fryktoria/arduino_Gaming_Controller/schematics/Sheet_2.png

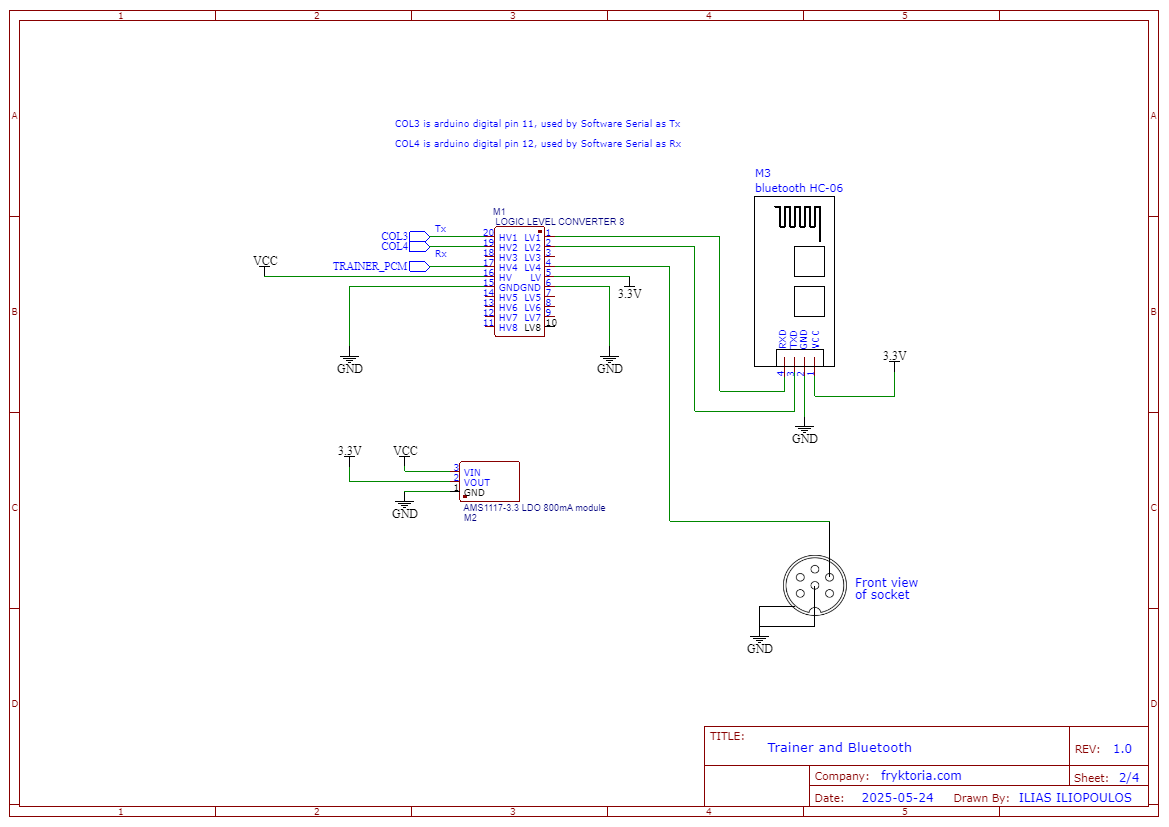
schematics/Sheet_2.png
