fryktoria/arduino_Gaming_Controller/schematics/Sheet_3.png

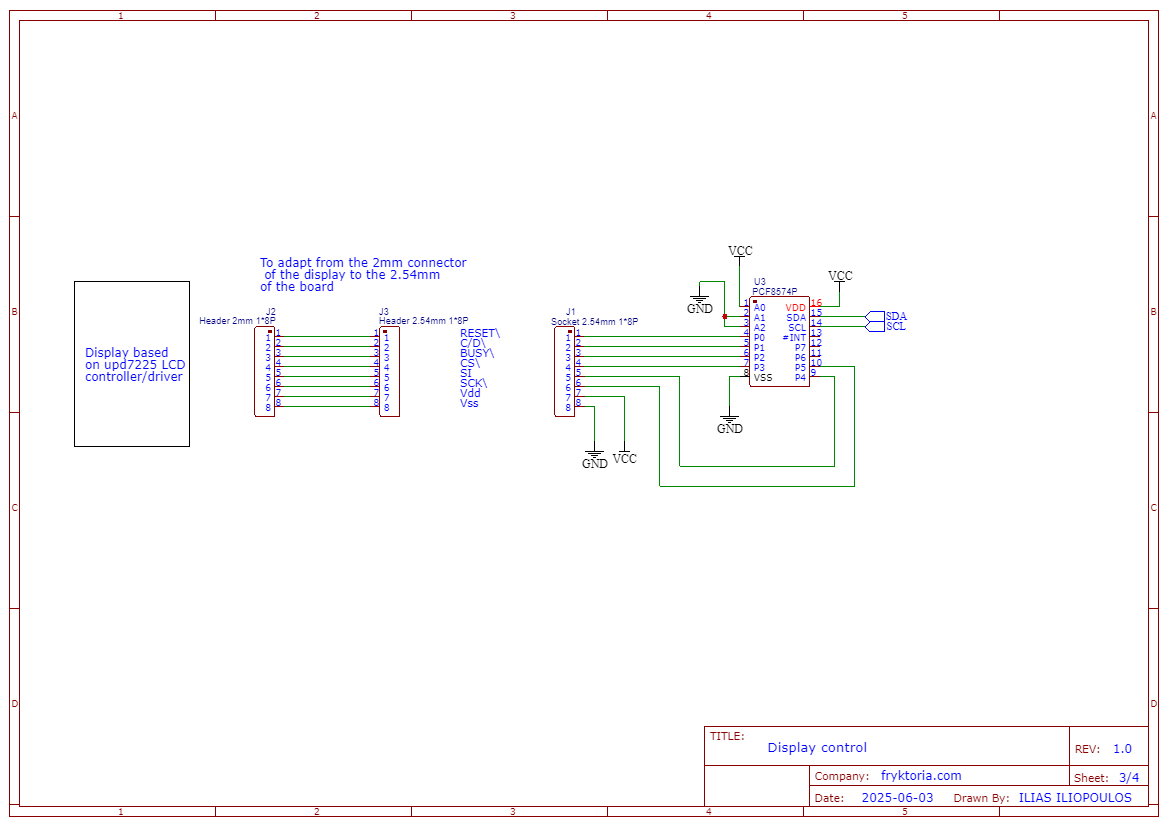
schematics/Sheet_3.png
