fryktoria/arduino_Gaming_Controller/schematics/Sheet_4.png

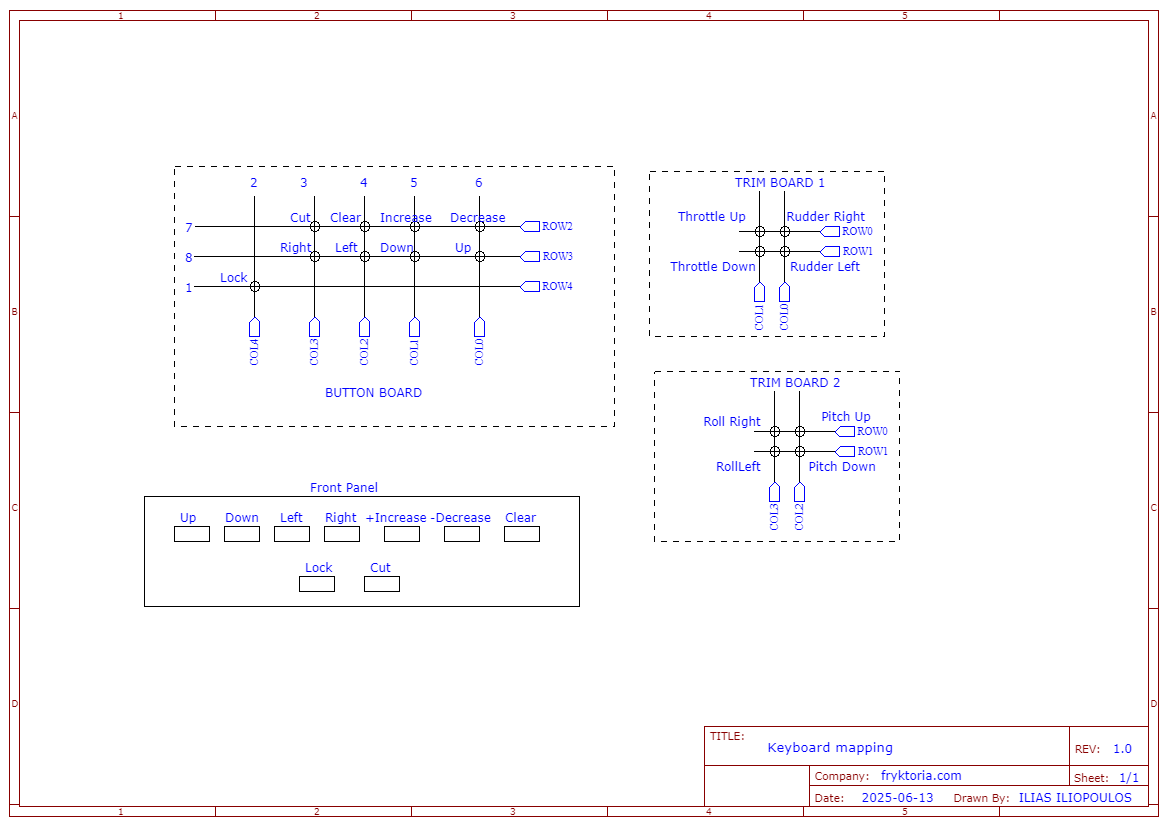
schematics/Sheet_4.png
