fryktoria/arduino_Gaming_Controller/schematics/schematics_pages.pdf

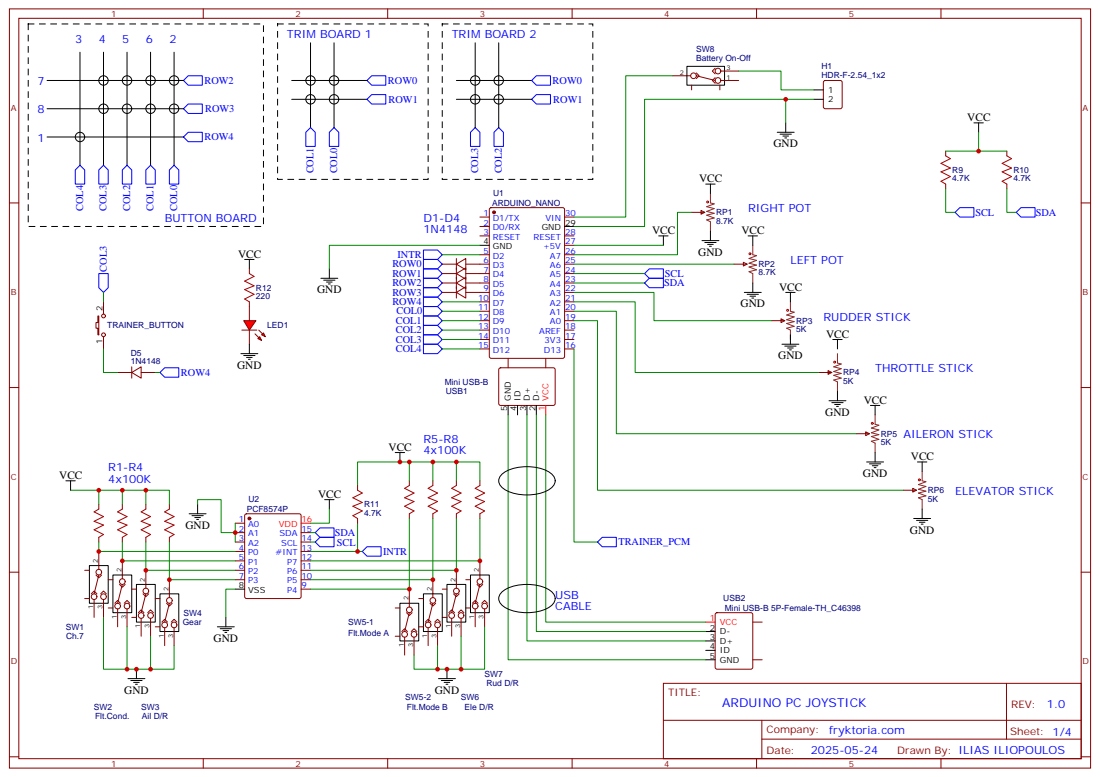
[picture p5: page 1]

P5 10 P6 11 P7 12 #INT 13 SCL 14 SDA 15 VDD 16

Drawn By: ILIAS ILIOPOULOS

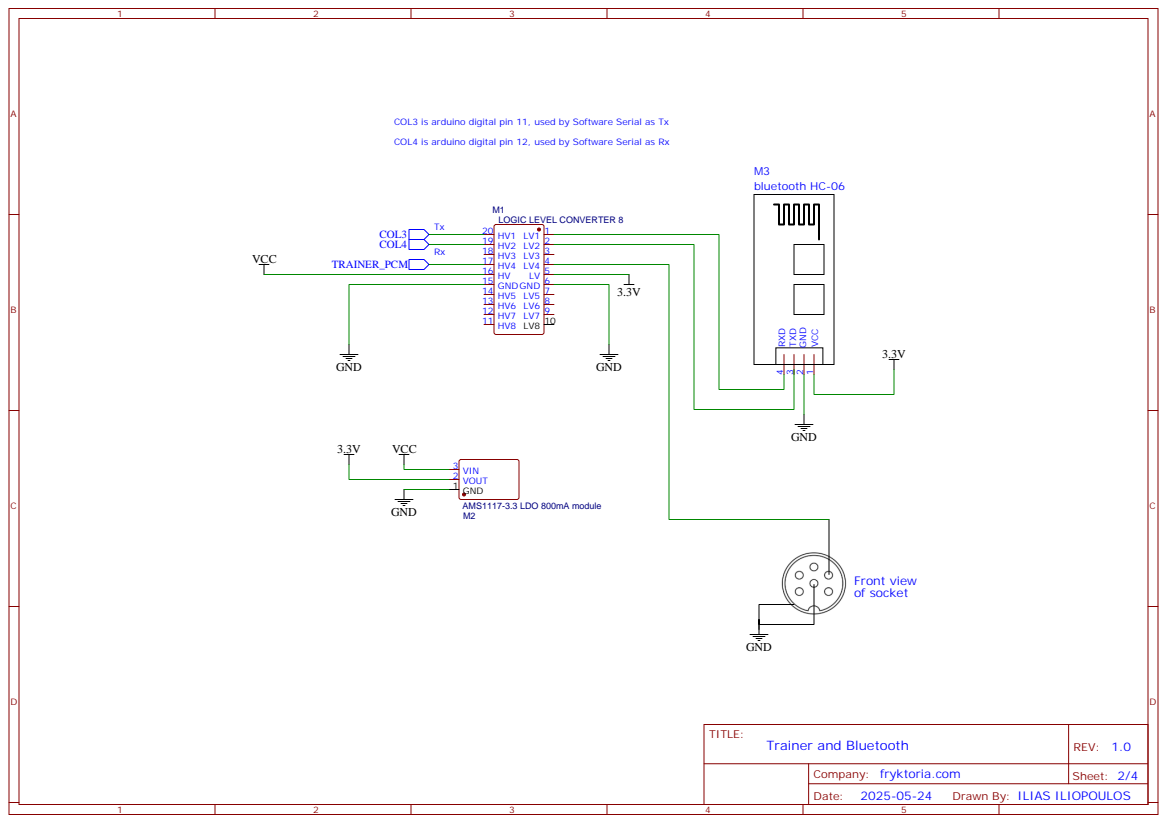
[picture p6: page 2]

COL3 is arduino digital pin 11, used by Software Serial as Tx
COL4 is arduino digital pin 12, used by Software Serial as Rx

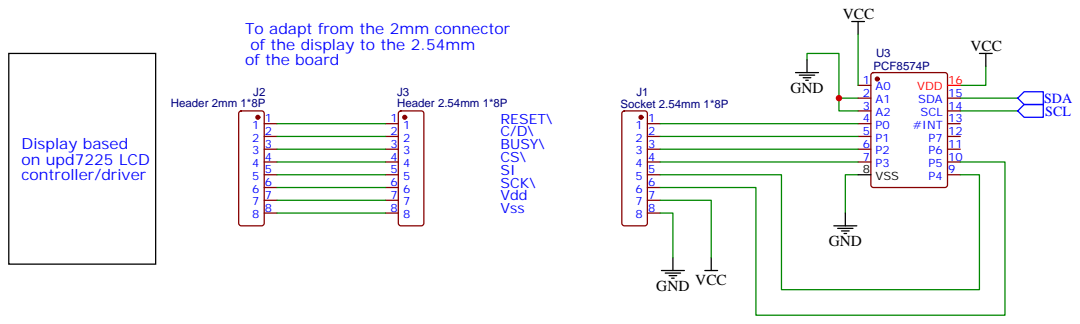
[picture p7: page 3]

To adapt from the 2mm connector
of the display to the 2.54mm
of the board

P5 10 P6 11 P7 12 #INT 13 SCL 14 SDA 15 VDD 16

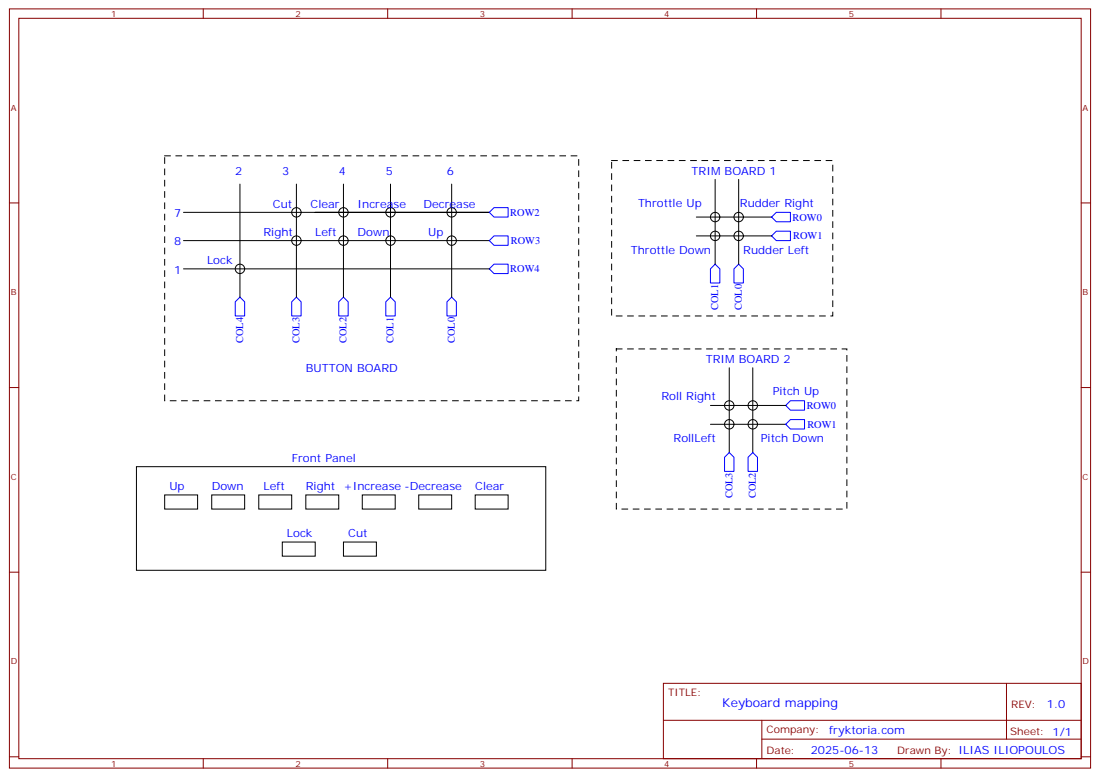
[picture p8: page 4]
