fryktoria/arduino_Gaming_Controller/arduino_Gaming_Controller/PPMEncoder.h

#ifndef _PPMEncoder_h_
#define _PPMEncoder_h_

#if defined(ARDUINO) && ARDUINO >= 100
#include "Arduino.h"
#else
#include "WProgram.h"
#endif

#define PPM_DEFAULT_CHANNELS 8

#define PPM_PULSE_LENGTH_uS 500
#define PPM_FRAME_LENGTH_uS 22500

class PPMEncoder {

  private:
  
    /*
       ILIAS ILIOPOULOS 2025-05-13
     Correction to the library. Necessary for proper operation of setChannel()
    //int16_t channels[10];
    */  
    volatile int16_t channels[10];
    uint16_t elapsedUs;

    uint8_t numChannels;
    uint8_t currentChannel;
    byte outputPin;
    boolean state;
    boolean enabled;
	
    uint8_t onState;
    uint8_t offState;


  public:
    static const uint16_t MIN = 1000;
    //static const uint16_t MAX = 3000;
    static const uint16_t MAX = 2000;

    void setChannel(uint8_t channel, uint16_t value);
    void setChannelPercent(uint8_t channel, uint8_t percent);

    void begin(uint8_t pin);
    void begin(uint8_t pin, uint8_t ch);
    void begin(uint8_t pin, uint8_t ch, boolean inverted);

    void disable();
    void enable();

    void interrupt();
};

extern PPMEncoder ppmEncoder;

#endif
